obono/ESP8266LivingSensor/NetworkManager.cpp

#include "NetworkManager.h"
#include "Credentials.h"

#define WIFI_BOOT_WAIT_MS   4000
#define WIFI_RETRY_COUNT    25
#define WIFI_RETRY_WAIT_MS  400

#define HTTPS_PORT          443
#define HTTP_CONTENT_TYPE   "application/json"
#define HTTP_RETRY_COUNT    5
#define HTTP_SUCCESS_RESPONSE "Success\r\n"

NetworkManager::NetworkManager(void)
{
    // do nothing
}

NetworkManager::~NetworkManager()
{
    // do nothing
}

bool NetworkManager::setupWiFi(void)
{
    delay(WIFI_BOOT_WAIT_MS - millis());
    WiFi.mode(WIFI_STA);
#ifdef STATIC_ADDRESS
    WiFi.config(staticIP, subnet, gateway, dns);
#endif
    WiFi.begin(MY_SSID, MY_PASSWORD);
    bool ret = false;
    for (int i = 0; i < WIFI_RETRY_COUNT; i++) {
        if (WiFi.status() == WL_CONNECTED) {
            ret = true;
            dprintln(F("Connected to SSID \"" MY_SSID "\""));
            break;
        }
        delay(WIFI_RETRY_WAIT_MS);
    }
    return ret;
}

bool NetworkManager::uploadRecords(String &recordsPayload)
{
    HTTPSRedirect* pClient = new HTTPSRedirect(HTTPS_PORT);
    if (pClient == nullptr) return false;

    bool ret = false;
    pClient->setInsecure();
    pClient->setContentTypeHeader(HTTP_CONTENT_TYPE);
    String payload = "{\"token\":\"" GAS_TOKEN "\",\"records\":" + recordsPayload + "}";
    for (int i = 0; !ret && i < HTTP_RETRY_COUNT; i++) {
        dprint(F("Connecting..."));
        if (pClient->connect(GAS_HOST, HTTPS_PORT)) {
            dprint(F("Posting..."));
            bool isCalled = pClient->POST(GAS_PATH, GAS_HOST, payload, false);
            if (isCalled) {
                int httpCode = pClient->getStatusCode();
                dprint(F("HTTP status="));
                dprintln(httpCode);
                if (httpCode == HTTP_CODE_OK) {
                    String response = pClient->getResponseBody();
                    dprint(response);
                    ret = (response != NULL && response.equals(HTTP_SUCCESS_RESPONSE));
                }
            } else {
                dprintln(F("Failed!!"));
            }
        } else {
            dprintln(F("Failed!!"));
        }
    }
    dprintln();

    delete pClient;
    return ret;
}
